cSquaerd/FTSD/fourteenSegDisplay-OnACard/fourteenSegDisplay-OnACard-Revised.png

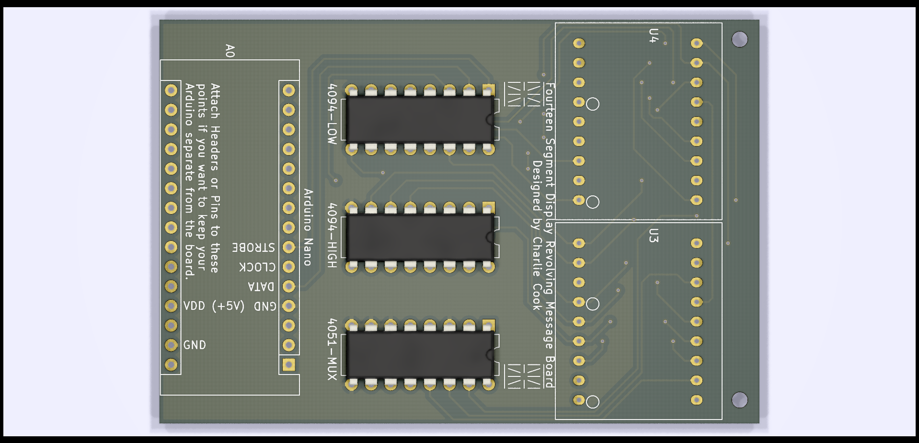
fourteenSegDisplay-OnACard/fourteenSegDisplay-OnACard-Revised.png
