cSquaerd/FTSD/fourteenSegDisplay-OnACard/fourteenSegDisplay-OnACard.kicad_pcb

## KiCad design fourteenSegDisplay-OnACard/fourteenSegDisplay-OnACard.kicad_pcb (2020-05-05)

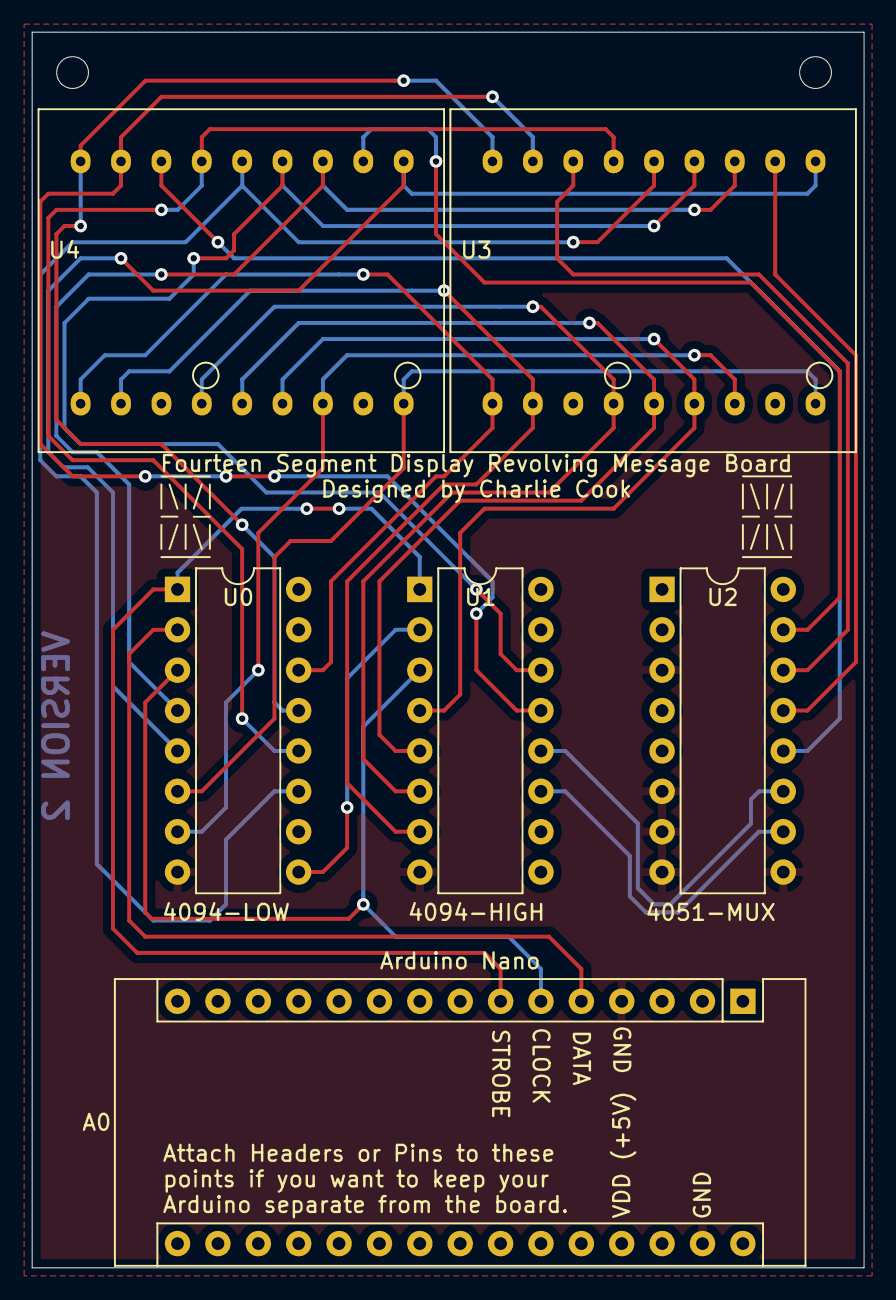
[picture p2: board fourteenSegDisplay-OnACard.kicad_pcb from above]

Board: 2 copper layers, 52.3 x 77.7 mm, 6 parts (0 on the bottom side), 26 nets.

Parts:
A0: Arduino_Nano_v3.x; Arduino_Nano
U0, U1: 4094; DIP-16_W7.62mm
U2: 4051; DIP-16_W7.62mm
U3, U4: LTP-3784

Connections:
+5V: A0.27, U0.15, U0.16, U1.15, U1.16, U2.16
GND: A0.4, A0.29, U0.8, U1.8, U2.3, U2.6, U2.7, U2.8, U2.9
unnamed: A0.5, U0.2
unnamed: A0.6, U0.3, U1.3
unnamed: A0.7, U0.1, U1.1
unnamed: U0.4, U3.12, U4.12
unnamed: U0.5, U3.10, U4.10
unnamed: U0.6, U3.9, U4.9
unnamed: U0.7, U3.7, U4.7
unnamed: U0.9, U1.2
unnamed: U0.11, U3.14, U4.14
unnamed: U0.12, U3.15, U4.15
unnamed: U0.13, U3.18, U4.18
unnamed: U0.14, U3.1, U4.1
unnamed: U1.4, U3.6, U4.6
unnamed: U1.5, U3.5, U4.5
unnamed: U1.6, U3.4, U4.4
unnamed: U1.7, U3.2, U4.2
unnamed: U1.11, U2.10
unnamed: U1.12, U2.11
unnamed: U1.13, U3.17, U4.17
unnamed: U1.14, U3.13, U4.13
unnamed: U2.12, U4.16
unnamed: U2.13, U3.11
unnamed: U2.14, U3.16
unnamed: U2.15, U4.11
